cataldo91/Bassino/Progetto Arduino/Bassino.ino

#include <Adafruit_Sensor.h>
#include <DHT.h> 
#include "DHT.h" //libreria per la lettura del sensore temperatura
#include <LiquidCrystal.h>// libreria per lo schermo LCD
#include <CapacitiveSensor.h>// libreria per la lettura del sensore capacitivo
CapacitiveSensor capSensor= CapacitiveSensor(4,5);


// definisco alcuni pin
#define trigpin A1
#define echopin A2
#define trigPin 13
#define echoPin 12
#define led A3
#define sx A4
#define dx A5
#define DHTPIN A0 //pin di lettura del dht
#define DHTTYPE DHT11// dht11 è il tipo di sensore che uso

int ledState=0;
int ledState2=0;
unsigned long previousMillis = 0; //memorizza l'ultimo tempo di aggiornamento
unsigned long interval = 60; //intervallo di azione
unsigned long previousMillis2 = 0;
unsigned long interval2 = 80;
unsigned long previousMillis3 = 0; 
unsigned long interval3 = 2000; 
unsigned long previousMillis4 = 0; 
unsigned long interval4 =30;


extern unsigned long timer0_millis;//var per azzerare il tempo
float s=0;//var globale per evitare che si azzeri constantemente. utilizzata per il calcolo della distanza

LiquidCrystal lcd(6, 7, 8, 9, 10, 11);//pin dello schermo


DHT dht(DHTPIN, DHTTYPE);//setto il sensore di temperatura
void setup() {
  
  Serial.begin (9600);
  pinMode(trigPin, OUTPUT);
  pinMode(echoPin, INPUT);
  pinMode(trigpin, OUTPUT);
  pinMode(echopin, INPUT);
  pinMode(led, OUTPUT);
  pinMode(sx, OUTPUT);
  pinMode(dx, OUTPUT);
  pinMode(2, INPUT);
  pinMode (3, INPUT);
  
 
  
  // i numeri all'interno di LCD indicano le righe e le colonne disponibili 
  lcd.begin(16, 2);
  lcd.setCursor(3,0);
  lcd.print("C");
  lcd.setCursor(3,1);
  lcd.print("%");
  lcd.setCursor(12,0);
  lcd.print("km/h");
  lcd.setCursor(12,1);
  lcd.print("km");
  //imposto le misure che verranno mostrate a video
}

void loop() {
  long sensor=capSensor.capacitiveSensor(5);
  float time,time2,v;
  long duration, distance, duration2, distance2,pressione, pressione2;
  unsigned long currentMillis = millis();
  
  //calcolo velocità
if(currentMillis - previousMillis2 > interval2) {
 previousMillis2 = currentMillis;
  if (sensor >14){
   
    Serial.println(sensor);
    time=millis();
    
     if(time>90){
     time=time/1000;
     Serial.print("sec ");
     Serial.println(time);

      v=((1.8)/(time))*3.6;
      s=s+0.0018;
      resetMillis();// azzero il tempo
     
     //delay(20);
      Serial.print("velocità");
      Serial.println(v);
      Serial.println(s);
      lcd.setCursor(7, 0);
      lcd.print(v);
      lcd.setCursor(7, 1);
      lcd.print(s);
      }
   
    }
   time2=millis();
  if(time2>1500){
    v=0.000;  
    lcd.setCursor(7, 0); 
    lcd.print(v);
  }  
}
 //fine calcolo velocità 
  
  
  
  
  
  
//inizio freni  

if(currentMillis - previousMillis4 > interval4) {
 previousMillis4 = currentMillis;

  digitalWrite(trigPin, LOW); 
  delayMicroseconds(2); 
  digitalWrite(trigPin, HIGH);
  delayMicroseconds(10); 
  digitalWrite(trigPin, LOW);
  duration = pulseIn(echoPin, HIGH);
  distance = (duration/2) / 29.1;
  
   
  digitalWrite(trigpin, LOW); 
  delayMicroseconds(2); 
  digitalWrite(trigpin, HIGH);
  delayMicroseconds(10); 
  digitalWrite(trigpin, LOW);
  duration2 = pulseIn(echopin, HIGH);
  distance2 = (duration2/2) / 29.1;

  if (distance < 5 || distance2<5) { 
 
    digitalWrite(led,HIGH); 
 
  
   }    else {    
     
    digitalWrite(led,LOW); 
 
    }
}
  

//fine freni
  





//start lettura temperatura


if(currentMillis - previousMillis3 > interval3) {
   previousMillis3 = currentMillis;
  
  int t= dht.readTemperature();
  int h = dht.readHumidity();
  lcd.setCursor(0, 0);
  lcd.print(t);
  lcd.setCursor(0, 1);
  lcd.print(h);
}

  //fine lettura temperatura
  
  
  
  
  //inizializzo i pulsanti per le frecce
pressione=digitalRead(2);
pressione2=digitalRead(3);
  
if(currentMillis - previousMillis > interval) {
  previousMillis = currentMillis; //salvo il tempo
  
  //freccesx(pressione,pressione2);
  
 if (pressione==HIGH  && pressione2==LOW){// partono le frecce di sinistra
     ledState2 ^= 1;
     digitalWrite(sx, ledState2);
  }
   else{
     ledState2=0;
     digitalWrite(sx,ledState2) ;
  }

  
  if (pressione2==HIGH && pressione==LOW){// partono le frecce di destra
  
    
    ledState ^= 1;
    digitalWrite(dx, ledState);
  }
   
  else{
    ledState=0;
    digitalWrite(dx,ledState) ;
    }
}
//fine frecce


 currentMillis=0;
  
}



//funzione per azzerare i millisecondi
void resetMillis() {
  cli();
  timer0_millis = 0;
  sei();
}
